JMichaelSutton/lantern/models/handle/new-handle.stl

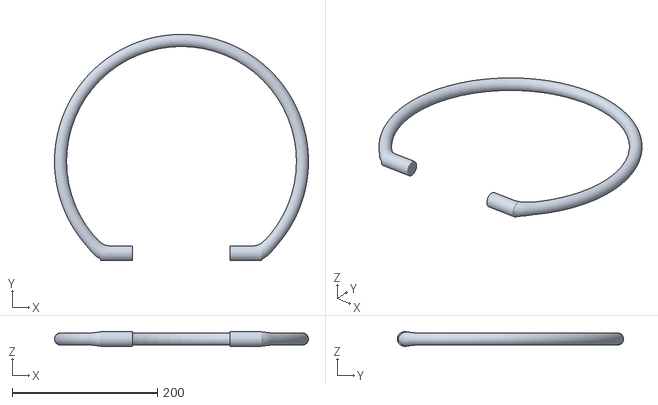
[picture p1: CAD file, 2026-10-13]
models/handle/new-handle.stl
350.0 x 311.7 x 20.4
