JMichaelSutton/lantern/models/handle/print/handle-pins-x15.stl

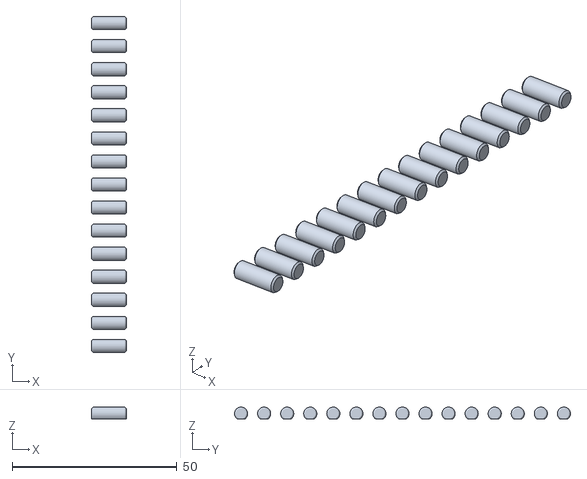
[picture p2: CAD file, 2026-10-13]
models/handle/print/handle-pins-x15.stl
10.5 x 102.0 x 3.60
