JMichaelSutton/lantern/models/handle/print/handle-lower-1-right.stl

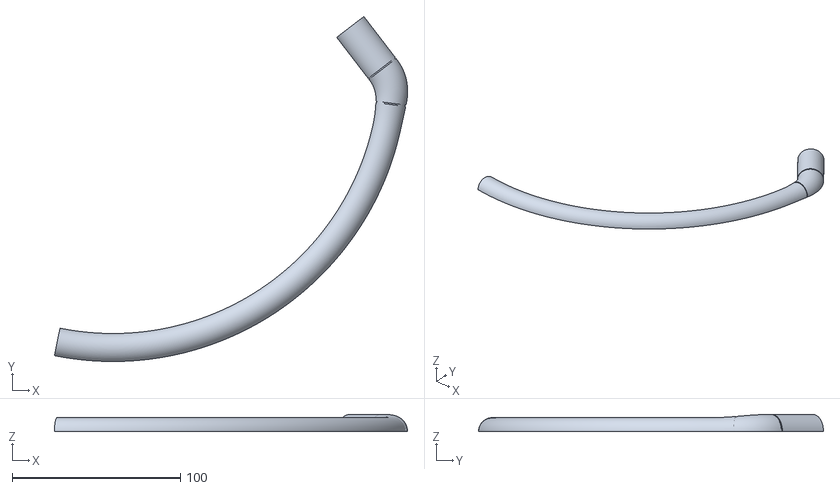
[picture p3: CAD file, 2026-10-13]
models/handle/print/handle-lower-1-right.stl
210.0 x 205.2 x 10.2
