JMichaelSutton/lantern/models/handle/print/handle-lower-2-middle.stl

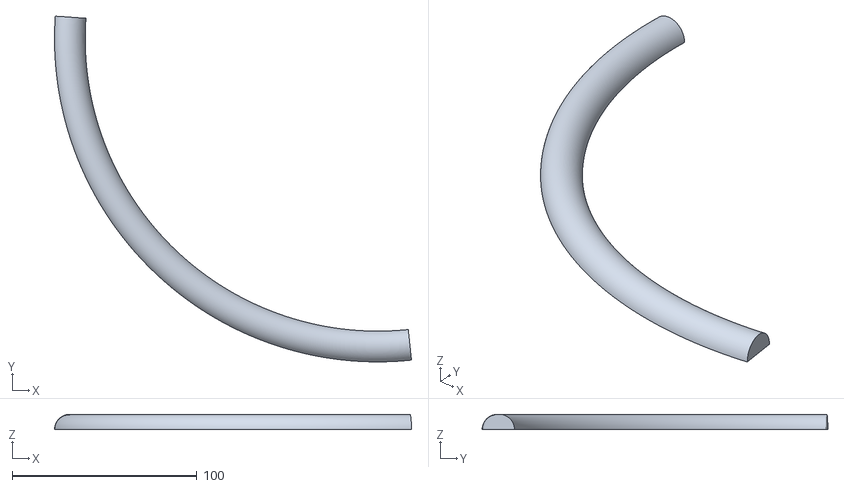
[picture p4: CAD file, 2026-10-13]
models/handle/print/handle-lower-2-middle.stl
193.3 x 187.2 x 8.33
