JMichaelSutton/lantern/models/handle/print/handle-lower-3-left.stl

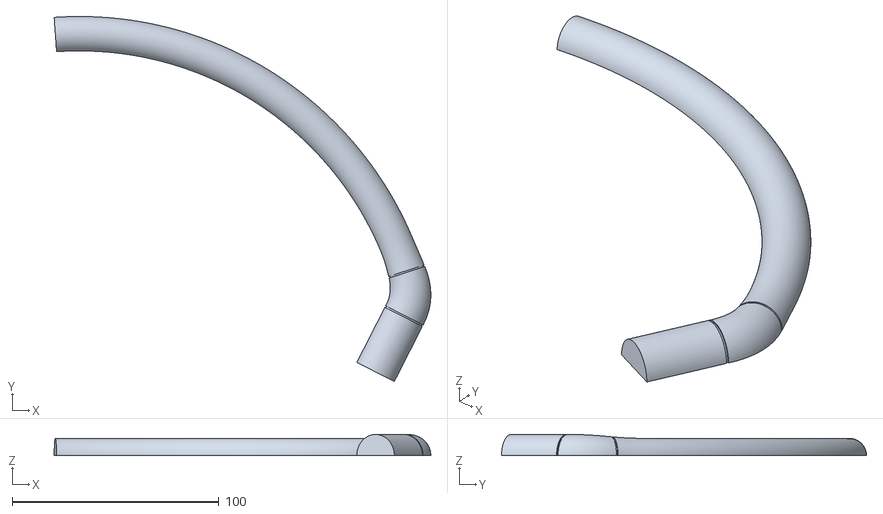
[picture p5: CAD file, 2026-10-13]
models/handle/print/handle-lower-3-left.stl
182.4 x 176.8 x 10.2
