JMichaelSutton/lantern/models/handle/print/handle-upper-3-left.stl

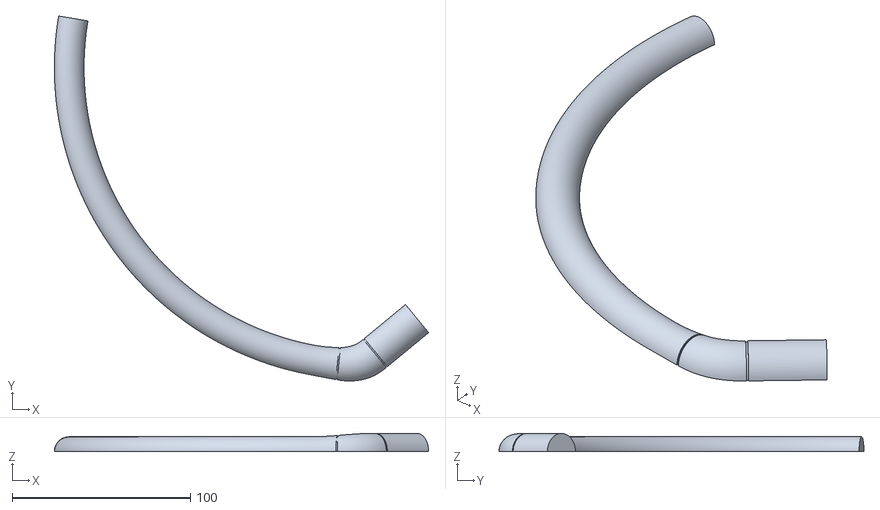
[picture p6: CAD file, 2026-10-13]
models/handle/print/handle-upper-3-left.stl
209.7 x 204.5 x 10.2
