JMichaelSutton/lantern/(list of files, cad)

Other CAD files:
models/handle/print/handle-upper-2-middle.stl
models/handle/print/handle-upper-1-right.stl
