JMichaelSutton/lantern/(commit log)

2026-10-13 Split lantern handle into flat-printing halves with alignment pins
    Cut the bail handle in its own plane so each half prints flat with layer
    lines along the handle. Adds nine 4 mm pin holes (seven on the arc, one per
    end block), a mirrored second half, a pin plate, the generating script, and
    print/assembly notes.
    Claude-Session: https://claude.ai/code/session_01RxevutJZbaDQgkHnFgZXBk
    [handle-half-a.stl, handle-half-b.stl, handle-pins-x10.stl, new-handle.stl]
2026-10-13 Cut handle into six bed-sized sections and add inset grooves
    Each half is now cut into three sections that fit a 220 x 215 mm bed, with
    the joints in the two halves staggered 18 degrees so none runs through the
    whole handle. Adds 0.8 x 0.5 mm grooves where the arc meets each elbow and
    where each elbow meets its barrel, at the CAD face boundaries measured from
    the mesh. Pins move off the joints: 13 pins plus 2 spares.
    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
    [handle-half-a.stl, handle-half-b.stl, handle-lower-1-right.stl, handle-lower-2-middle.stl, handle-lower-3-left.stl, handle-pins-x10.stl, handle-pins-x15.stl, handle-upper-1-right.stl]
